gbjo-dev/DIY_FND_Clock/FND_Clock_Vr0.1_sch.pdf

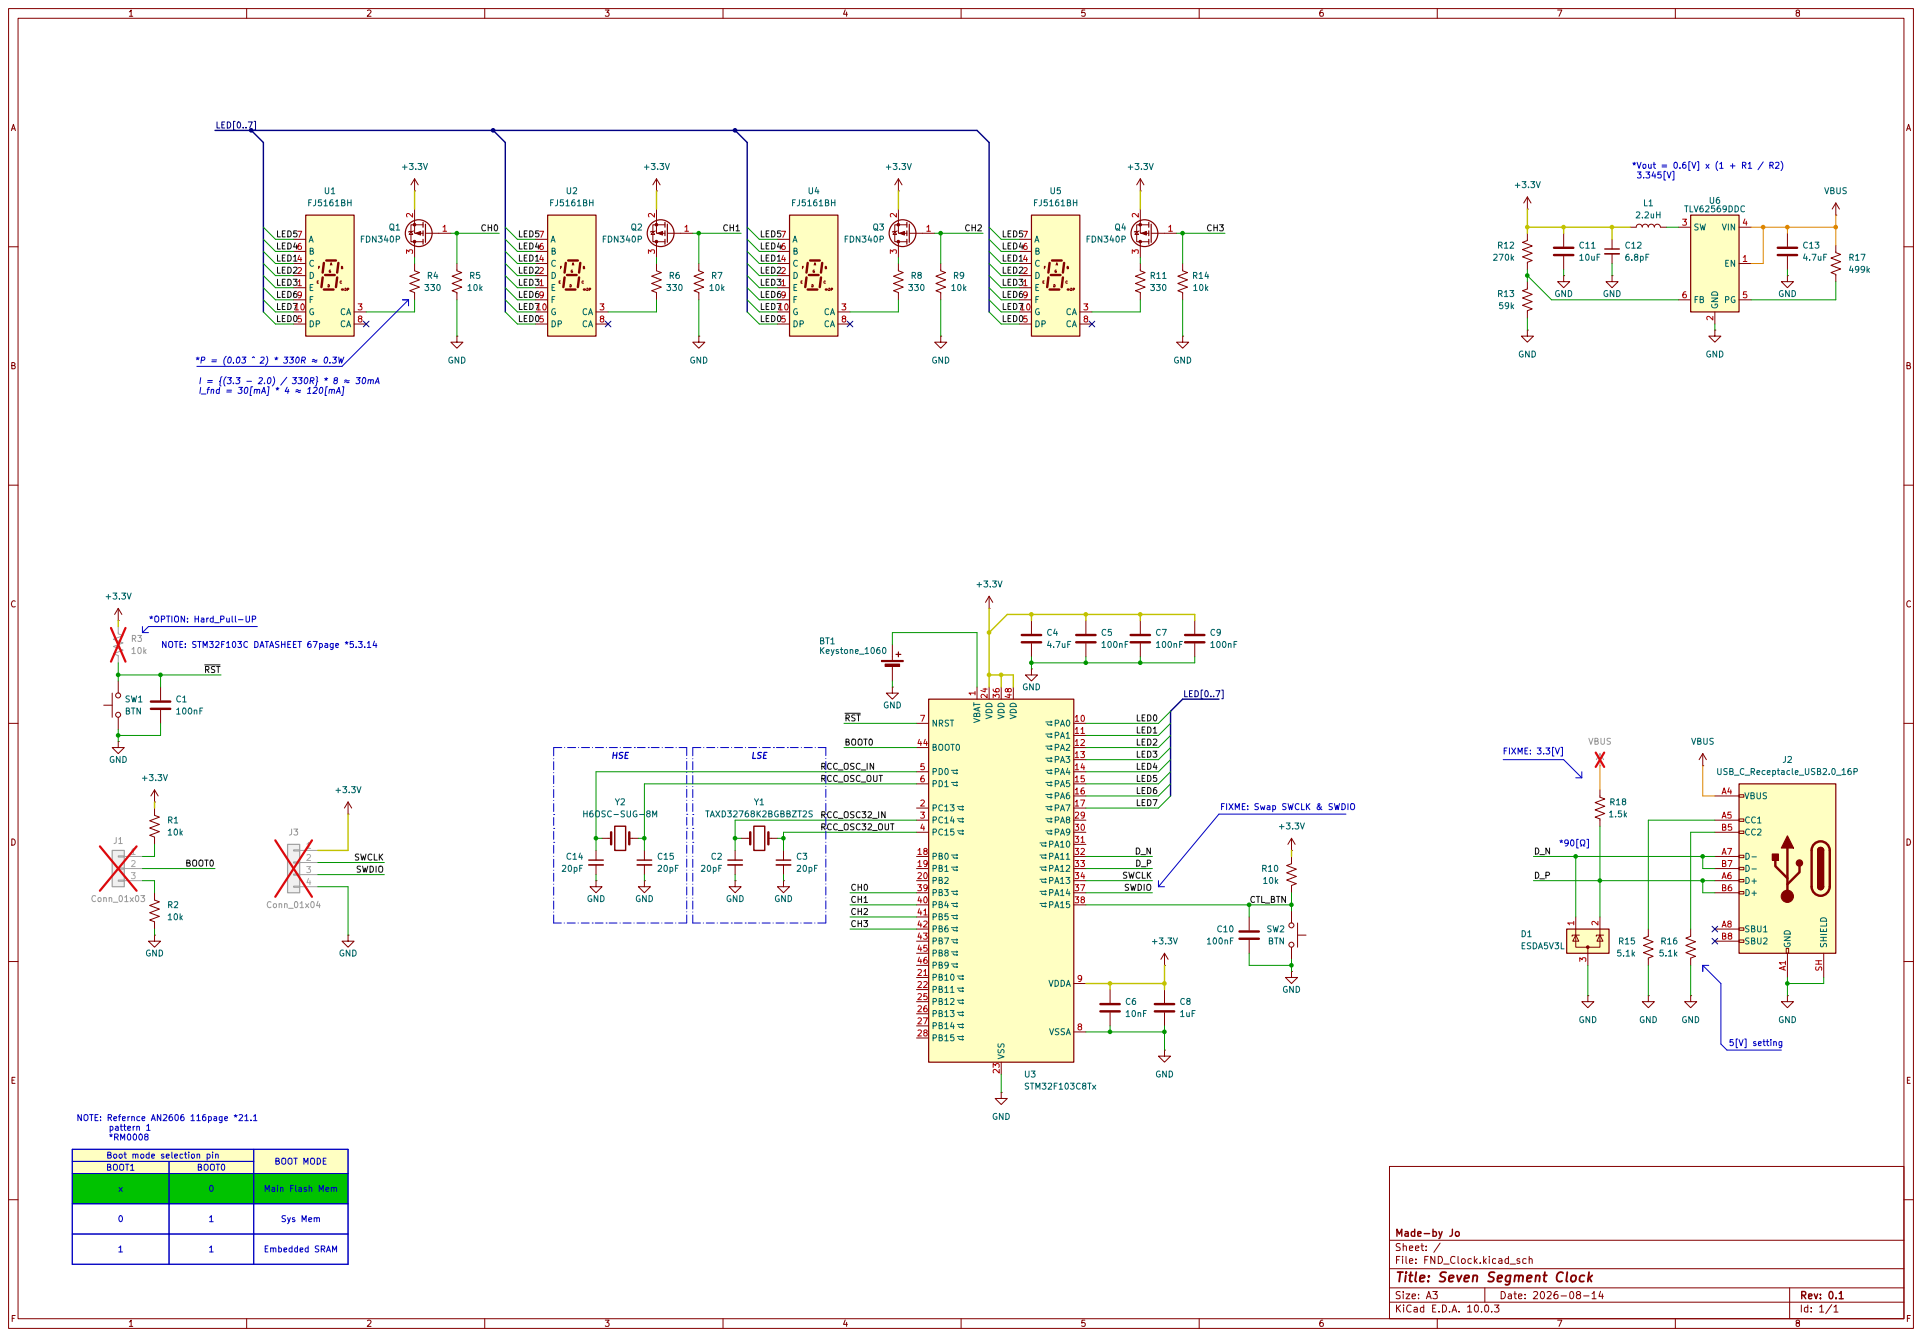
[picture p1: page 1]
