gbjo-dev/DIY_FND_Clock/SW/Core/Src/main.c

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
/* Includes ------------------------------------------------------------------*/
#include "main.h"
#include "stdbool.h"
/* USER CODE BEGIN PTD */
typedef enum Button{
	event_Short = 0,
	event_Long,
	event_None
} ButtonEvent_t;

typedef enum {
	MODE_NOMAL = 0, // 일반 시계 모드
	MODE_SET_HOUR, // '시' 변경 모드 ( 깜빡임 효과 )
	MODE_SET_MIN // '분' 변경 모드
} clockMode_t;

/* USER CODE END PTD */

RTC_HandleTypeDef hrtc;

PCD_HandleTypeDef hpcd_USB_FS;

/* USER CODE BEGIN PV */

clockMode_t clock_mode = MODE_NOMAL;

RTC_TimeTypeDef set_time = {0}; // NOTE: 시간 설정할 때 사용할 구조체

static const uint8_t FND_NUM[] = {
// 				 LED:  7 6 5 4 3 2 1 0
// 				 FND:  G F A B E D C DP
		0x81, // 0 (0b 1 0 0 0 0 0 0 1)
		0xED, // 1 (0b 1 1 1 0 1 1 0 1)
		0x43, // 2 (0b 0 1 0 0 0 0 1 1)
		0x49, // 3 (0b 0 1 0 0 1 0 0 1)
		0x2D, // 4 (0b 0 0 1 0 1 1 0 1)
		0x19, // 5 (0b 0 0 0 1 1 0 0 1)
		0x11, // 6 (0b 0 0 0 1 0 0 0 1)
		0xCD, // 7 (0b 1 1 0 0 1 1 0 1)
		0x01, // 8 (0b 0 0 0 0 0 0 0 1)
		0x09  // 9 (0b 0 0 0 0 1 0 0 1)
		};
/* USER CODE END PV */

void SystemClock_Config(void);
static void MX_GPIO_Init(void);
static void MX_USB_PCD_Init(void);
static void MX_RTC_Init(void);
/* USER CODE BEGIN PFP */
void Display_FND(uint8_t hours, uint8_t minutes, clockMode_t mode, bool blink_state);

ButtonEvent_t Button_event(GPIO_TypeDef *port, uint16_t gpio);
/* USER CODE END PFP */

/**
  * @brief  The application entry point.
  * @retval int
  */
int main(void)
{

  /* MCU Configuration--------------------------------------------------------*/

  /* Reset of all peripherals, Initializes the Flash interface and the Systick. */
  HAL_Init();

  /* Configure the system clock */
  SystemClock_Config();

  /* Initialize all configured peripherals */
  MX_GPIO_Init();
  MX_USB_PCD_Init();
  MX_RTC_Init();
	/* Infinite loop */
	/* USER CODE BEGIN WHILE */
	RTC_TimeTypeDef sTime = { 0 };
	RTC_DateTypeDef sDate = { 0 };

	uint32_t last_rtc_tick = 0;
	uint32_t last_blink_tick = 0;
	bool blink_state = true;


	HAL_RTC_GetTime(&hrtc, &sTime, RTC_FORMAT_BIN);
	HAL_RTC_GetDate(&hrtc, &sDate, RTC_FORMAT_BIN);

	while (1) {

		ButtonEvent_t btn_event = Button_event(CTL_BTN_GPIO_Port, CTL_BTN_Pin);

		// NOTE: Long Key를 눌러서 설정모드로 진입.
		if (btn_event == event_Long) {

			if (clock_mode == MODE_NOMAL) {

				HAL_RTC_GetTime(&hrtc, &sTime, RTC_FORMAT_BIN);
				HAL_RTC_GetDate(&hrtc, &sDate, RTC_FORMAT_BIN);

				set_time = sTime;

				clock_mode = MODE_SET_HOUR;

			} else if (clock_mode == MODE_SET_HOUR) {
				clock_mode = MODE_SET_MIN;
			} else if (clock_mode == MODE_SET_MIN) {
				HAL_RTC_SetTime(&hrtc, &set_time, RTC_FORMAT_BIN);
				clock_mode = MODE_NOMAL;
			}

		} else if(btn_event == event_Short){
			// NOTE: Long key 이벤트 눌림 후 short key 이벤트를 받으면, 설정 진행.
			if(clock_mode == MODE_SET_HOUR){
				set_time.Hours = (set_time.Hours + 1) % 24;
			} else if(clock_mode == MODE_SET_MIN){
				set_time.Minutes = (set_time.Minutes +1 ) % 60;
				set_time.Seconds = 0;
			}
		}

		if (clock_mode == MODE_NOMAL) {
			if (HAL_GetTick() - last_rtc_tick >= 500) {

				last_rtc_tick = HAL_GetTick();

				HAL_RTC_GetTime(&hrtc, &sTime, RTC_FORMAT_BIN);
				HAL_RTC_GetDate(&hrtc, &sDate, RTC_FORMAT_BIN);
			}
		}

		if (HAL_GetTick() - last_blink_tick >= 300) {
			last_blink_tick = HAL_GetTick();
			blink_state = !blink_state;
		}

		if (clock_mode == MODE_NOMAL) {
			Display_FND(sTime.Hours, sTime.Minutes, MODE_NOMAL, true);
		} else{
			Display_FND(set_time.Hours, set_time.Minutes, clock_mode, blink_state);
		}


		/* USER CODE END WHILE */

		/* USER CODE BEGIN 3 */
	}
	/* USER CODE END 3 */
}

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
/* USER CODE BEGIN 4 */
// return event_Short, event_Long, event_None
ButtonEvent_t Button_event(GPIO_TypeDef *port, uint16_t gpio) {
	static bool busy = false;
	static bool event_done = false;
	static uint32_t temp_tick = 0;

	if (!HAL_GPIO_ReadPin(port, gpio)) {

		if (!busy) {
			temp_tick = HAL_GetTick();
			event_done = false;
			busy = true;
		}

		if ((HAL_GetTick() - temp_tick >= 1000) && !event_done) {
			event_done = true;
			return event_Long;
		}
	}

	else {

		if (busy) {
			busy = false;

			if (!event_done) {
				event_done = true;

				if (HAL_GetTick() - temp_tick >= 50) {
					return event_Short;
				}
			}
		}
	}

	return event_None;
}

void Display_FND(uint8_t hours, uint8_t minutes, clockMode_t mode, bool blink_state){
	uint8_t digits[4];
	digits[0] = hours / 10;
	digits[1] = hours % 10;
	digits[2] = minutes / 10;
	digits[3] = minutes % 10;

	GPIO_TypeDef *CH_PORT[4] = { CH0_GPIO_Port, CH1_GPIO_Port, CH2_GPIO_Port, CH3_GPIO_Port };
	uint16_t CH_PIN[4] = { CH0_Pin, CH1_Pin, CH2_Pin, CH3_Pin };

	for (int i = 0; i < 4; i++) {

		for (int j = 0; j < 4; j++) { // NOTE: FND 채널 모두 Off.
			HAL_GPIO_WritePin(CH_PORT[j], CH_PIN[j], GPIO_PIN_SET);
		}

		GPIOA->ODR = (GPIOA->ODR & (~0xFF)) | 0xFF; // NOTE: segment 잔상 방지.

		bool show_digit = true;

		if (!blink_state) {
			if ((mode == MODE_SET_HOUR) && (i == 0 || i == 1)) { // NOTE: 시간 설정하고 FND 시간 2개 구간.
				show_digit = false; // NOTE: '시' 설정 중일 때 '시' 자리를 꺼둠
			} else if ((mode == MODE_SET_MIN) && (i == 2 || i == 3)) {
				show_digit = false; // NOTE:'분' 설정 중일 때 '분' 자리를 꺼둠
			}
		}

		if(show_digit){
			GPIOA->ODR = (GPIOA->ODR & (~0xFF)) | FND_NUM[digits[i]];
		} else{
			GPIOA->ODR = (GPIOA->ODR & (~0xFF)) | 0xFF;
		}

		HAL_GPIO_WritePin(CH_PORT[i], CH_PIN[i], GPIO_PIN_RESET);

		HAL_Delay(2);
	}

	for (int j = 0; j < 4; j++) {
		HAL_GPIO_WritePin(CH_PORT[j], CH_PIN[j], GPIO_PIN_SET);
	}
}



/* USER CODE END 4 */
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
