gbjo-dev/DIY_FND_Clock/SW/Core/Inc/main.h

#define LED0_Pin GPIO_PIN_0
#define LED0_GPIO_Port GPIOA
#define LED1_Pin GPIO_PIN_1
#define LED1_GPIO_Port GPIOA
#define LED2_Pin GPIO_PIN_2
#define LED2_GPIO_Port GPIOA
#define LED3_Pin GPIO_PIN_3
#define LED3_GPIO_Port GPIOA
#define LED4_Pin GPIO_PIN_4
#define LED4_GPIO_Port GPIOA
#define LED5_Pin GPIO_PIN_5
#define LED5_GPIO_Port GPIOA
#define LED6_Pin GPIO_PIN_6
#define LED6_GPIO_Port GPIOA
#define LED7_Pin GPIO_PIN_7
#define LED7_GPIO_Port GPIOA
#define CTL_BTN_Pin GPIO_PIN_15
#define CTL_BTN_GPIO_Port GPIOA
#define CH0_Pin GPIO_PIN_3
#define CH0_GPIO_Port GPIOB
#define CH1_Pin GPIO_PIN_4
#define CH1_GPIO_Port GPIOB
#define CH2_Pin GPIO_PIN_5
#define CH2_GPIO_Port GPIOB
#define CH3_Pin GPIO_PIN_6
#define CH3_GPIO_Port GPIOB
